AnttiLukats/OZOM-Model-A/README.md

# OZOM-Model-A
Open Hardware Zynq System on Module
