AnttiLukats/OZOM-Model-A/hw/pcb/manufacturing reports/PDF/SCH-ZOM-01.pdf

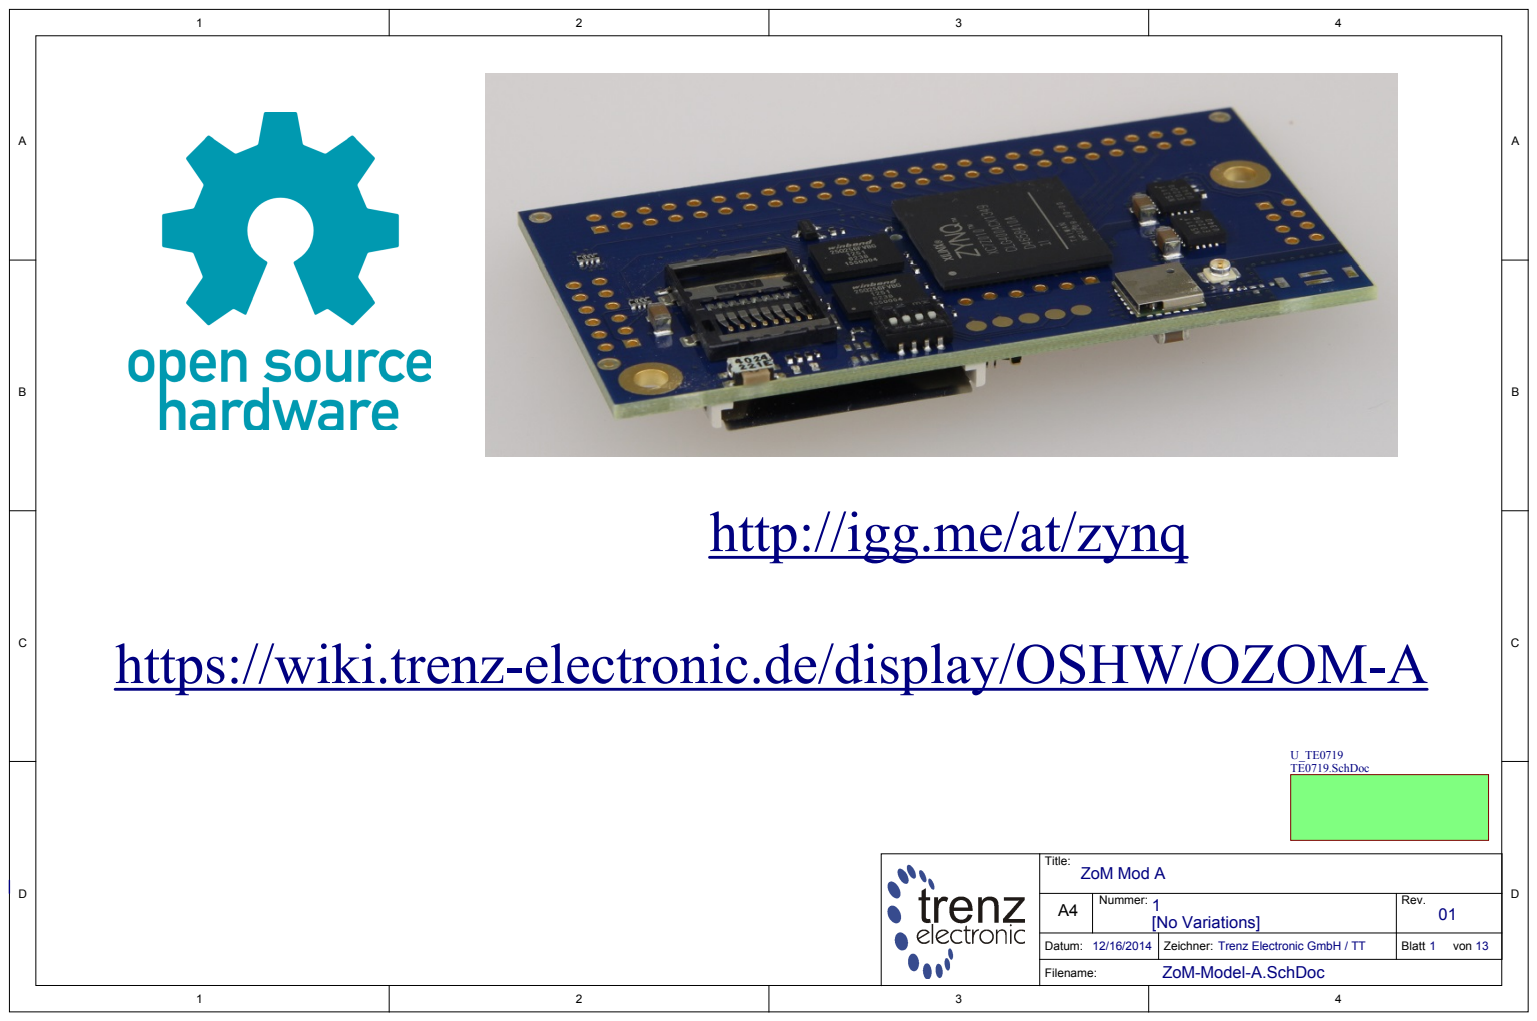
[picture p1: page 1]

http://igg.me/at/zynq

https://wiki.trenz-electronic.de/display/OSHW/OZOM-A

Title: ZoM Mod A

A4 | Nummer: 1 [No Variations] | Rev. 01

Datum: 12/16/2014 | Zeichner: Trenz Electronic GmbH / TT | Blatt 1 von 13

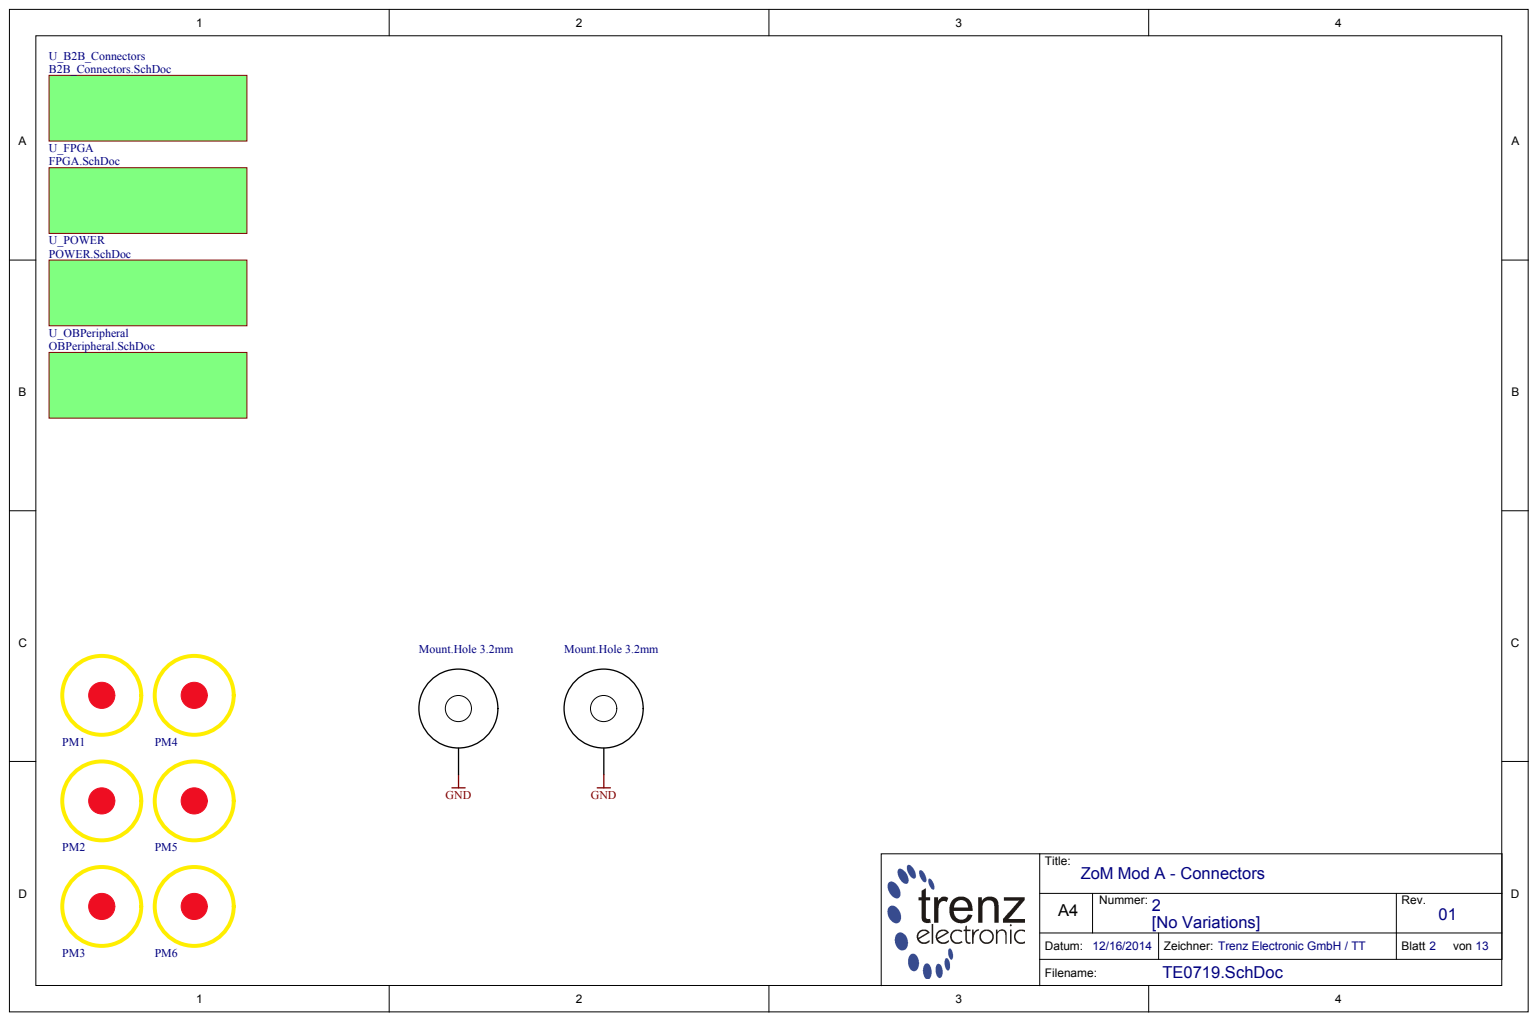
[picture p2: page 2]

Title: ZoM Mod A - Connectors

A4 | Nummer: 2 [No Variations] | Rev. 01

Datum: 12/16/2014 | Zeichner: Trenz Electronic GmbH / TT | Blatt 2 von 13

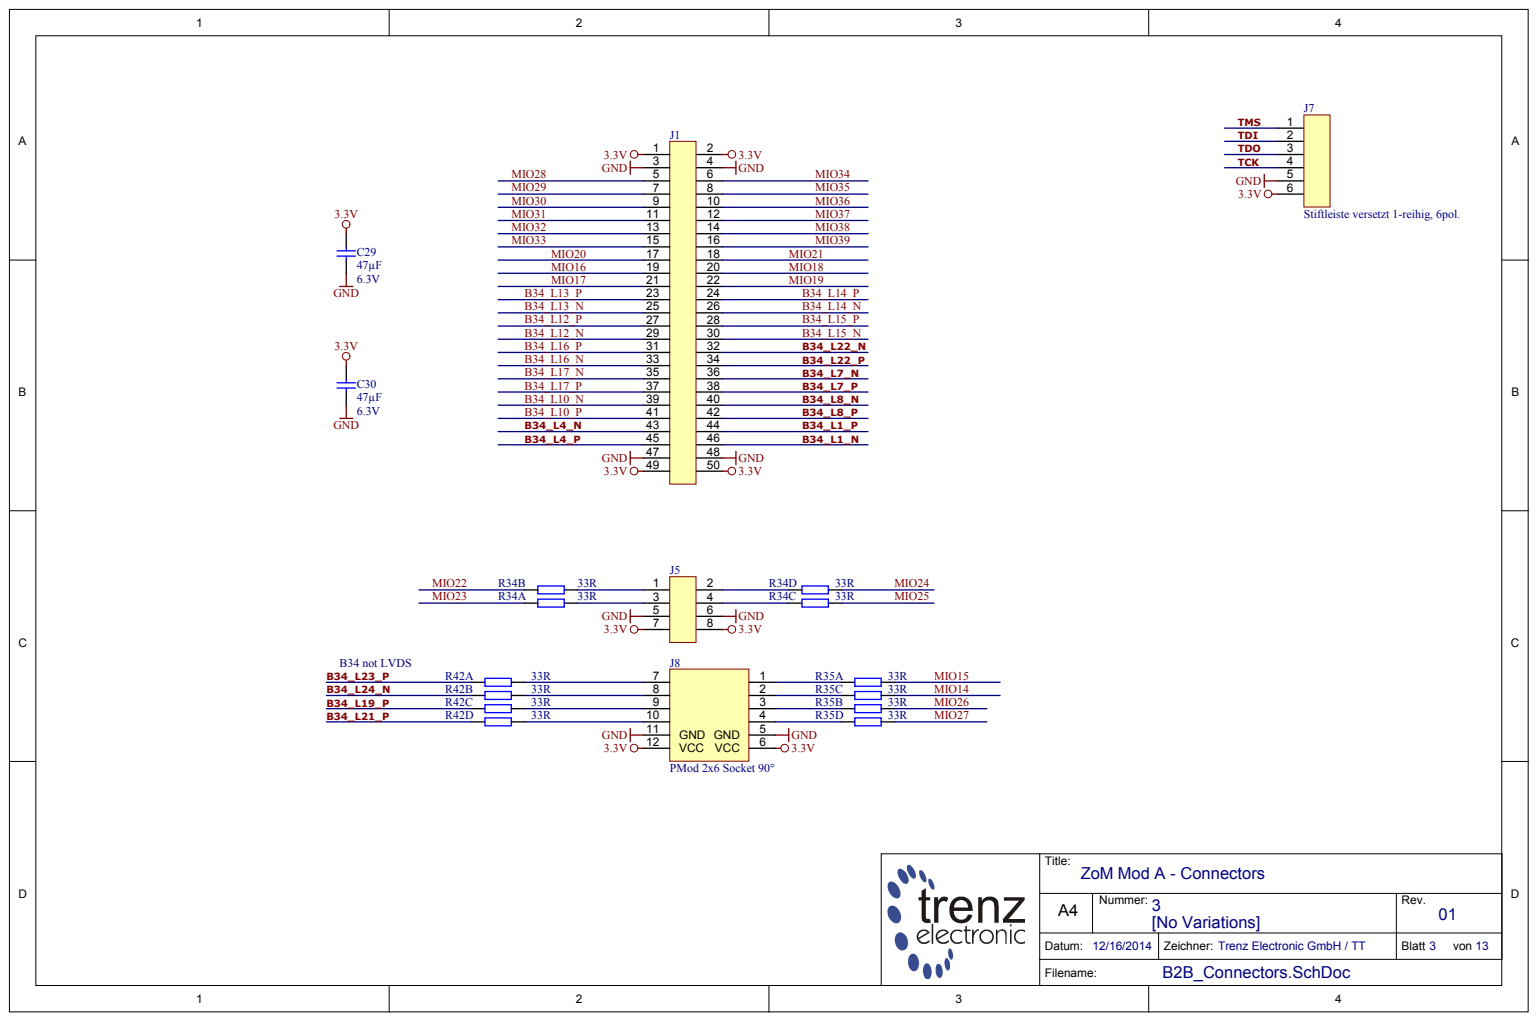
[picture p3: page 3]

TDI TDO TCK TMS

Title: ZoM Mod A - Connectors

A4 | Nummer: [No Variations] 3 | Rev. 01

Datum: 12/16/2014 | Zeichner: Trenz Electronic GmbH / TT | Blatt 3 von 13

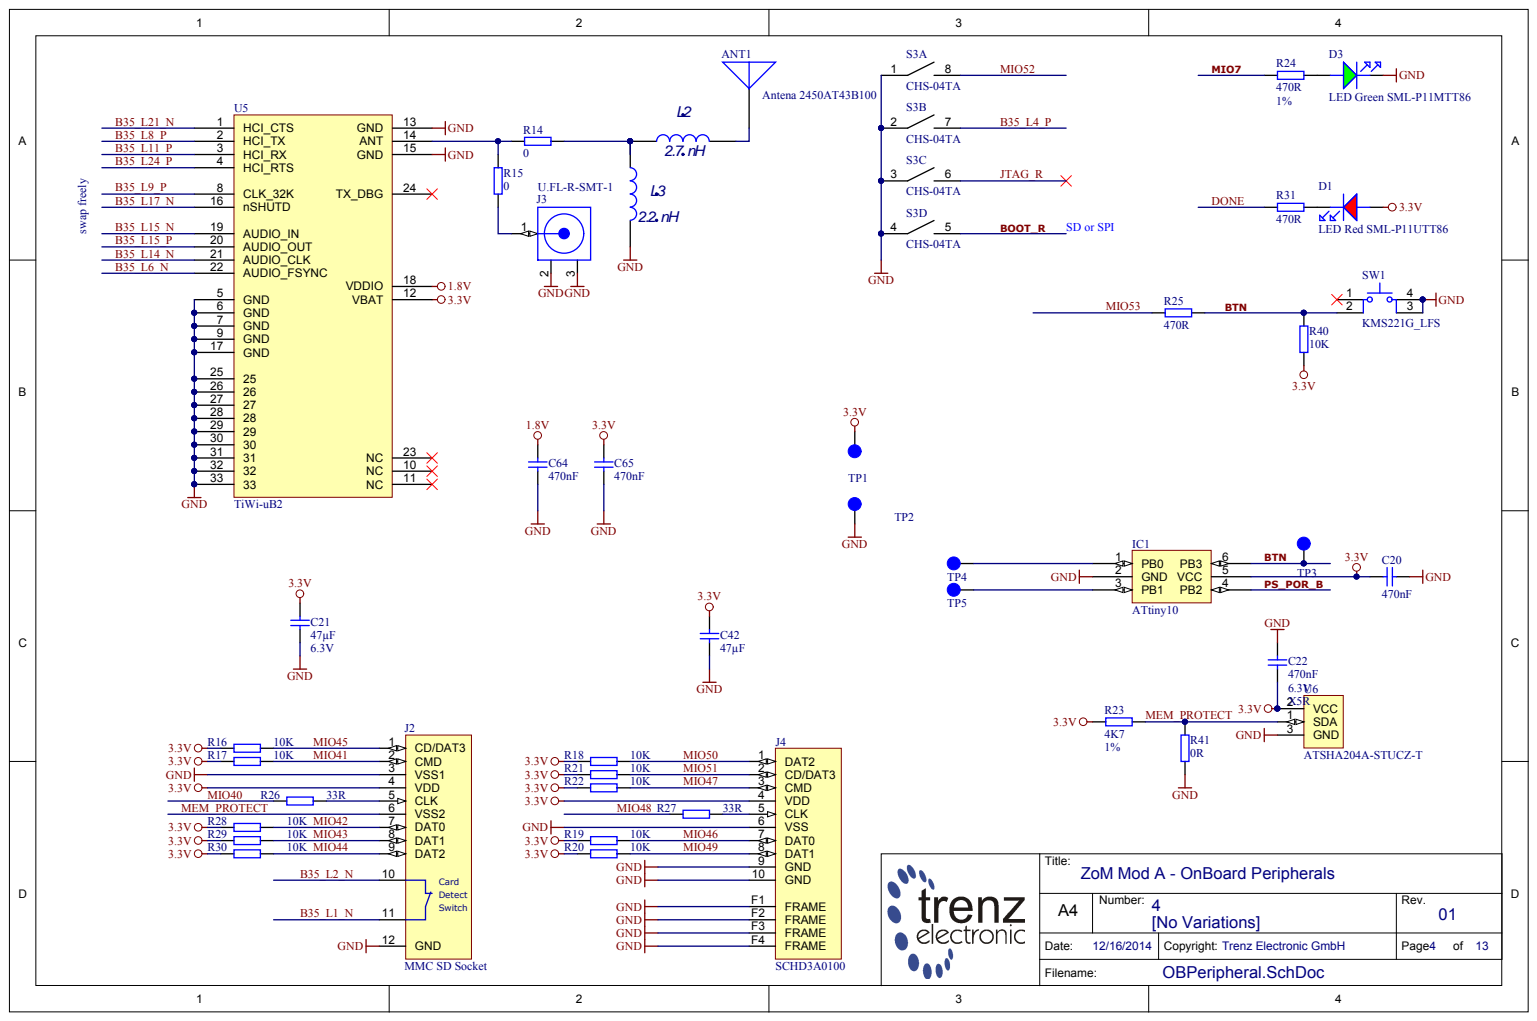
[picture p4: page 4]

Title: ZoM Mod A - OnBoard Peripherals

A4 | Number: 4 [No Variations] | Rev. 01

Copyright: Trenz Electronic GmbH

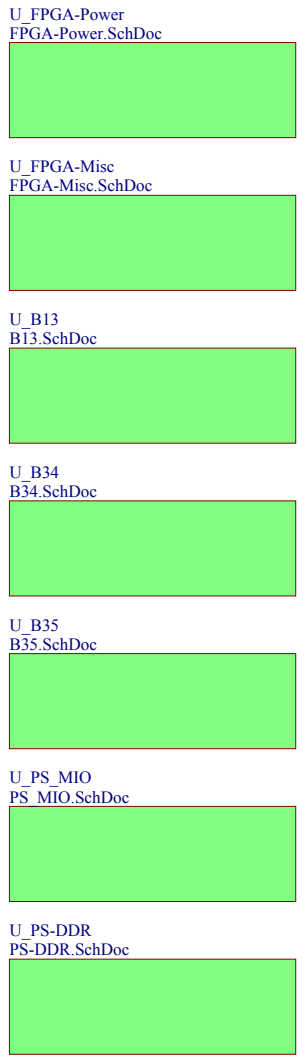
[picture p5: page 5]

Title: ZoM Mod A - FPGA

A4 | Number: 5 [No Variations] | Rev. 01

Date: 12/16/2014 | Copyright: Trenz Electronic GmbH | Page5 of 13

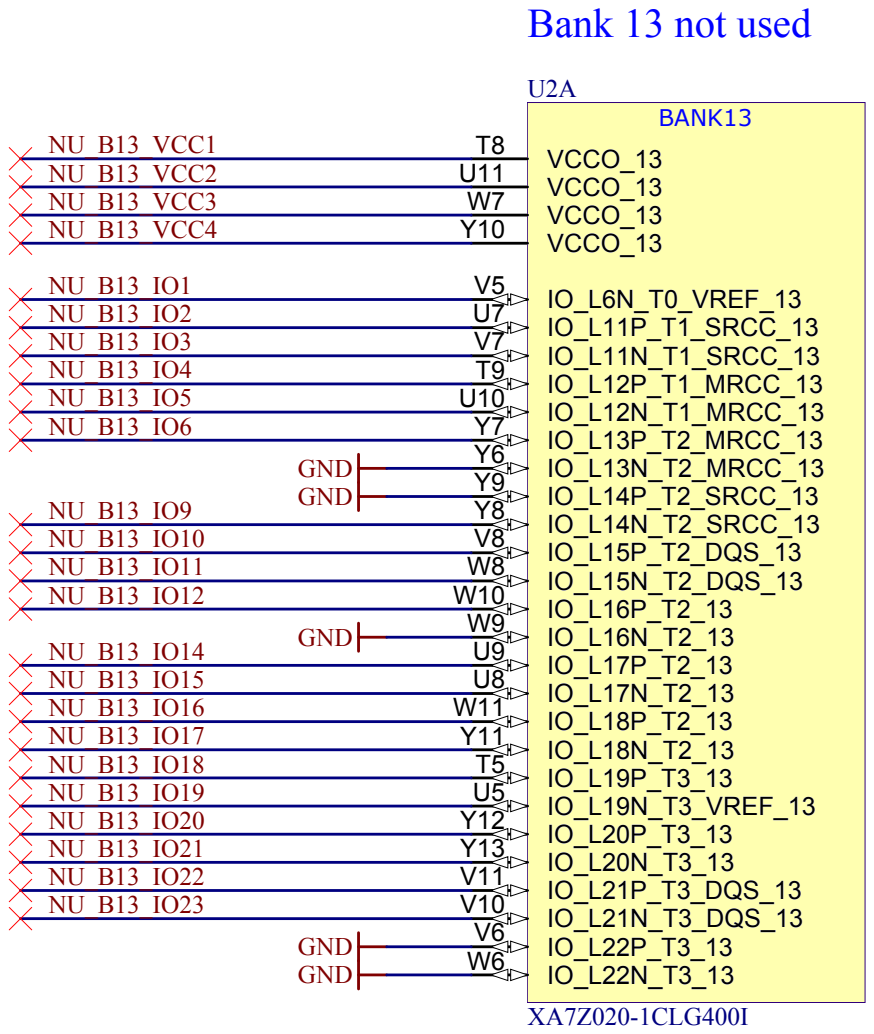
[picture p6: page 6]

Title: ZoM Mod A - FPGA Bank 13

A4 | Nummer: [No Variations] 6 | Rev. 01

Datum: 12/16/2014 | Zeichner: Trenz Electronic GmbH / TT | Blatt 6 von 13

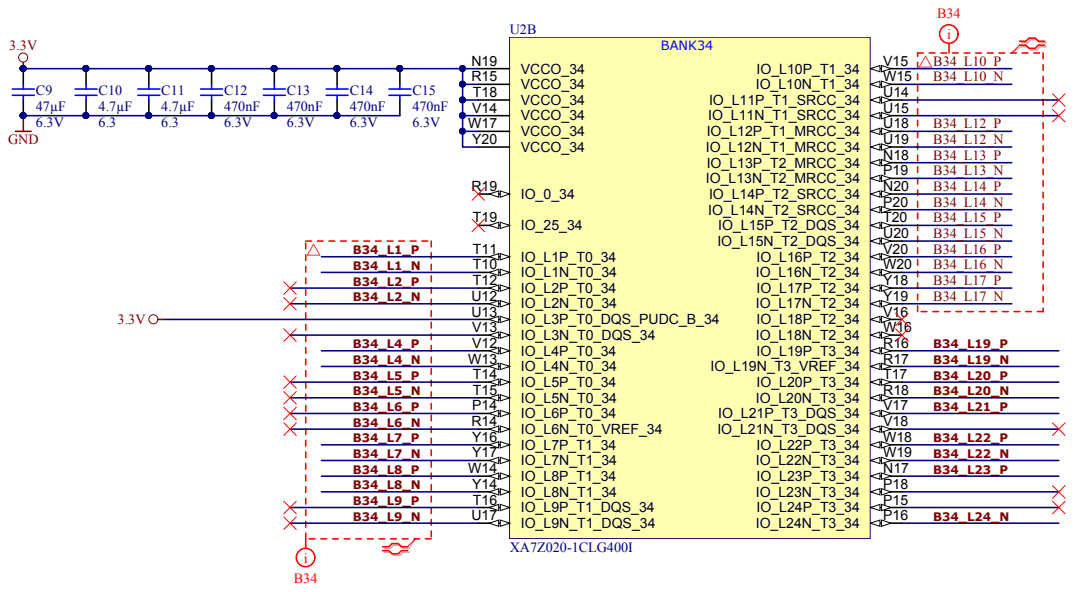
[picture p7: page 7]

Title: ZoM Mod A - FPGA Bank 34

A4 | Nummer: [No Variations] 7 | Rev. 01

Datum: 12/16/2014 | Zeichner: Trenz Electronic GmbH / TT | Blatt 7 von 13

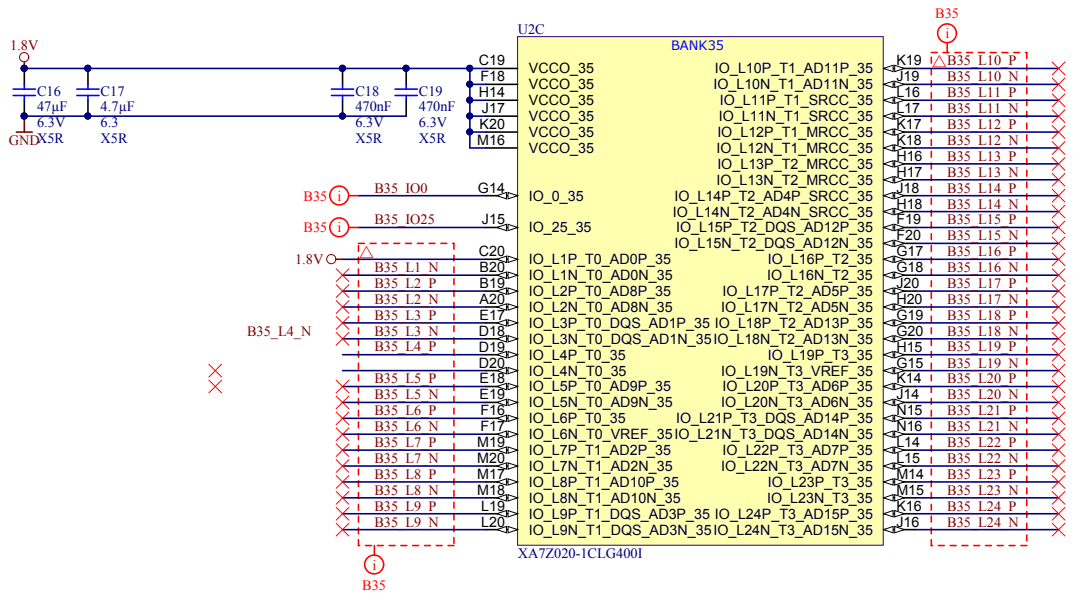
[picture p8: page 8]

IO_L1P_T0_AD0P_35 C20
IO_L1N_T0_AD0N_35 B20

B35_L2_P | IO_L2P_T0_AD8P_35 B19
B35_L2_N | IO_L2N_T0_AD8N_35 A20
B35_L3_P | IO_L3P_T0_DQS_AD1P_35 E17
B35_L3_N | IO_L3N_T0_DQS_AD1N_35 D18
B35_L4_P | IO_L4P_T0_35 D19

B35_L5_P | IO_L5P_T0_AD9P_35 E18
B35_L5_N | IO_L5N_T0_AD9N_35 E19
B35_L6_P | IO_L6P_T0_35 F16
B35_L6_N | IO_L6N_T0_VREF_35 F17
B35_L7_P | IO_L7P_T1_AD2P_35 M19
B35_L7_N | IO_L7N_T1_AD2N_35 M20
B35_L8_P | IO_L8P_T1_AD10P_35 M17
B35_L8_N | IO_L8N_T1_AD10N_35 M18
B35_L9_P | IO_L9P_T1_DQS_AD3P_35 L19
B35_L9_N | IO_L9N_T1_DQS_AD3N_35 L20

Title: ZoM Mod A - FPGA Bank 35

A4 | Nummer: [No Variations] 8 | Rev. 01

Datum: 12/16/2014 | Zeichner: Trenz Electronic GmbH / TT | Blatt 8 von 13

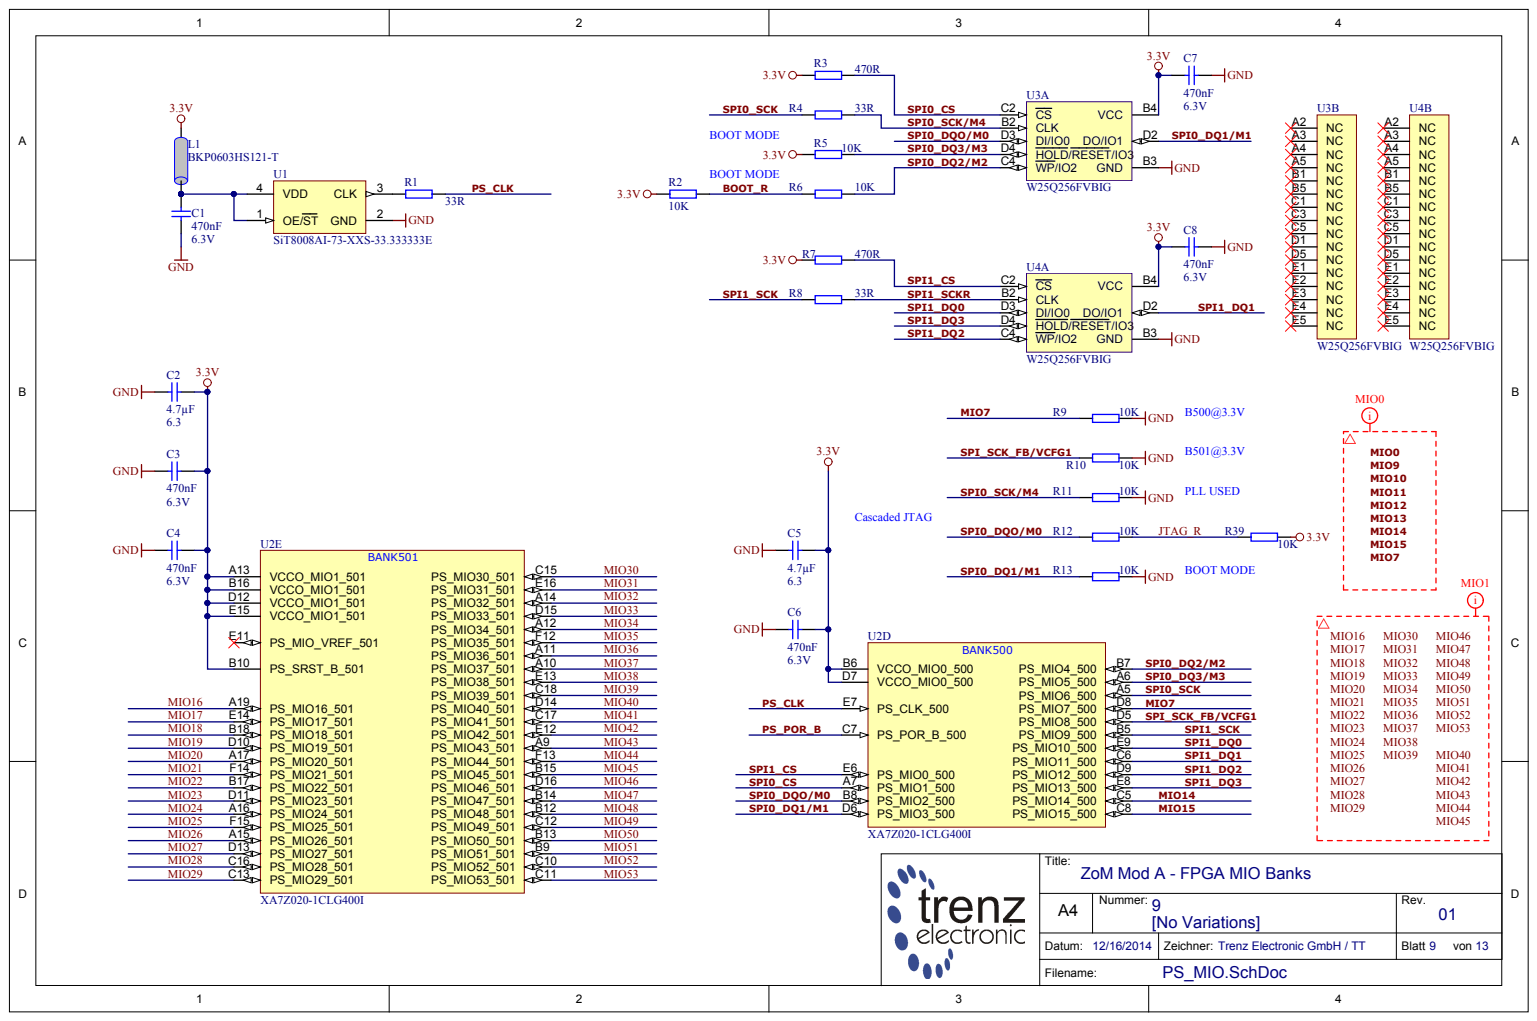
[picture p9: page 9]

Title: ZoM Mod A - FPGA MIO Banks

A4 | Nummer: 9 [No Variations] | Rev. 01

Datum: 12/16/2014 | Zeichner: Trenz Electronic GmbH / TT | Blatt 9 von 13

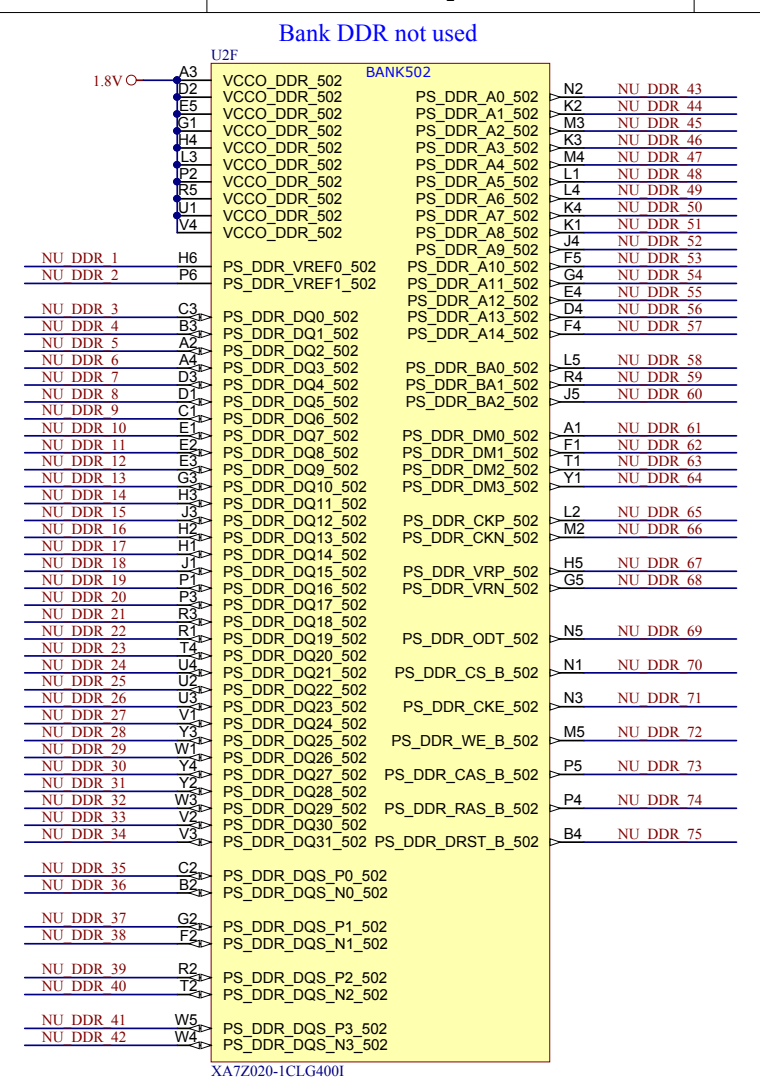
[picture p10: page 10]

Bank DDR not used

Title: ZoM Mod A - FPGA DDR Bank

A4 | Nummer: 10 [No Variations] | Rev. 01

Datum: 12/16/2014 | Zeichner: Trenz Electronic GmbH / TT | Blatt 10 von 13

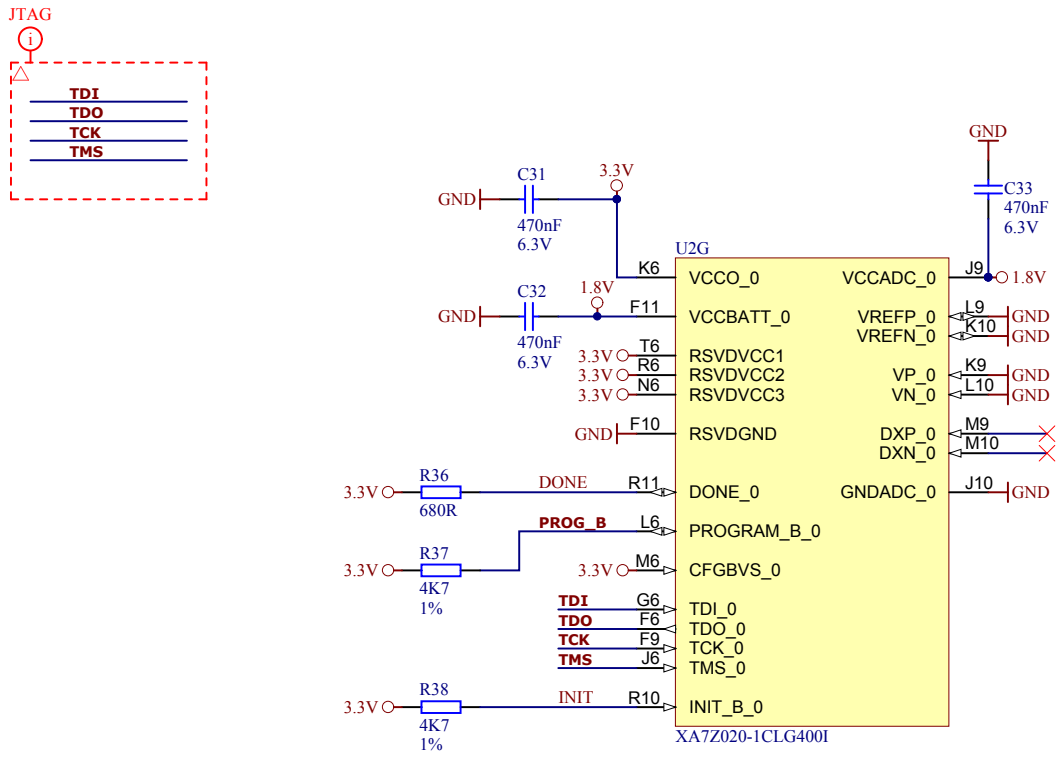
[picture p11: page 11]

Title: ZoM Mod A - FPGA MIsc

A4 | Nummer: 11 [No Variations] | Rev. 01

Datum: 12/16/2014 | Zeichner: Trenz Electronic GmbH / TT | Blatt 11 von 13

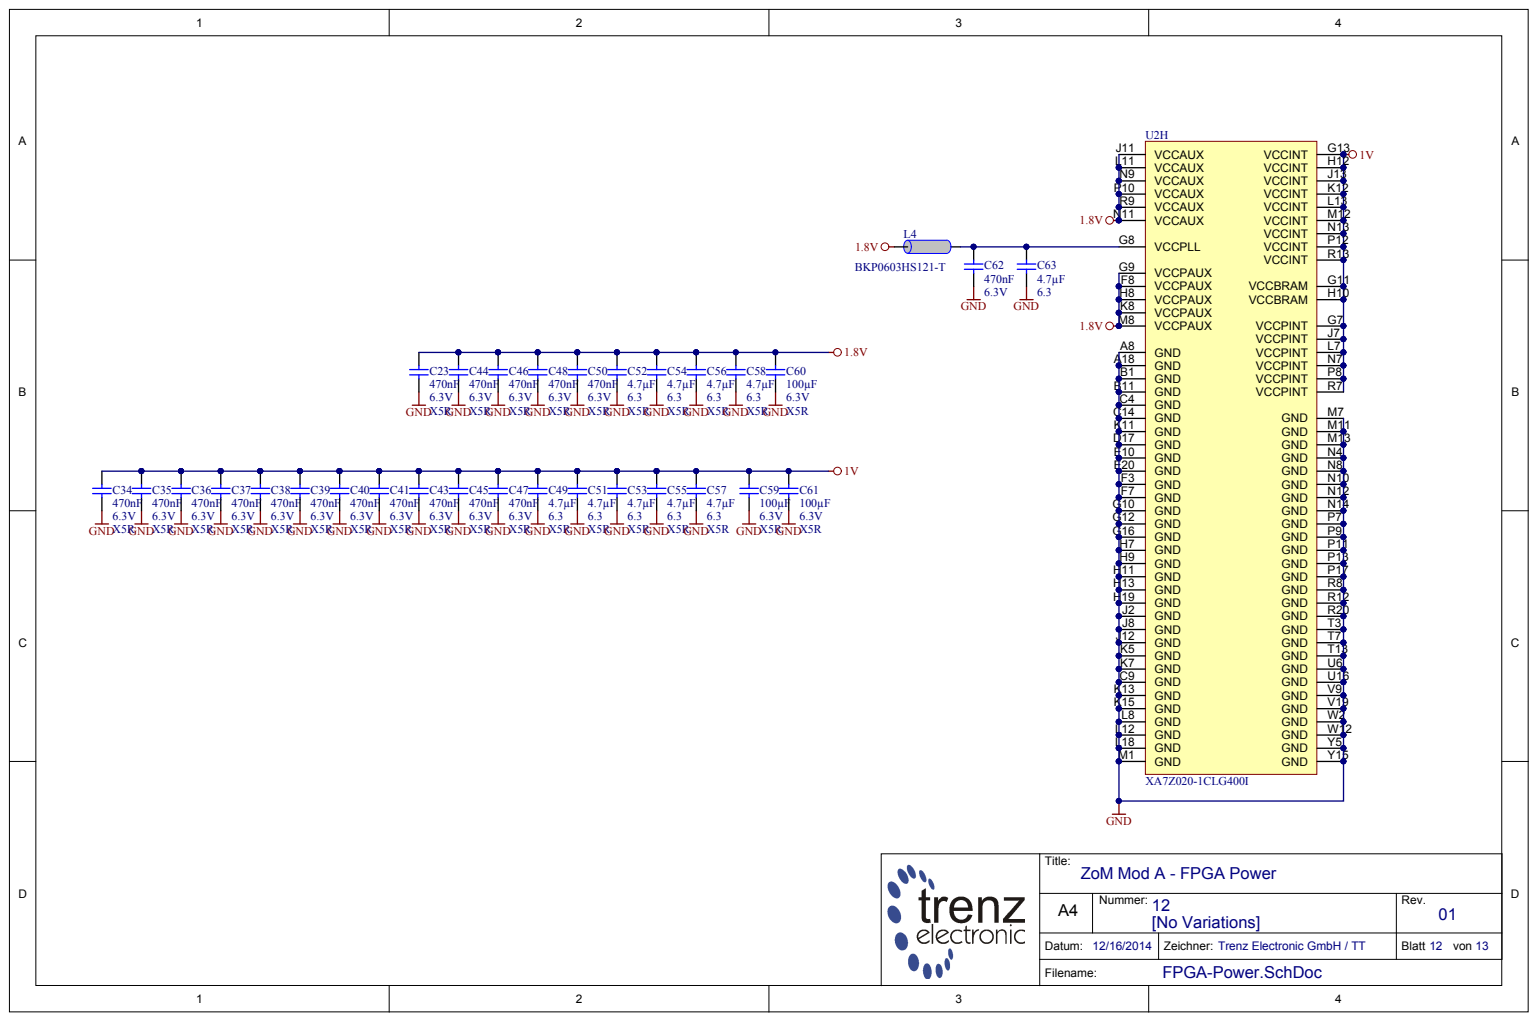
[picture p12: page 12]

Title: ZoM Mod A - FPGA Power

A4 | Nummer: 12 [No Variations] | Rev. 01

Datum: 12/16/2014 | Zeichner: Trenz Electronic GmbH / TT | Blatt 12 von 13

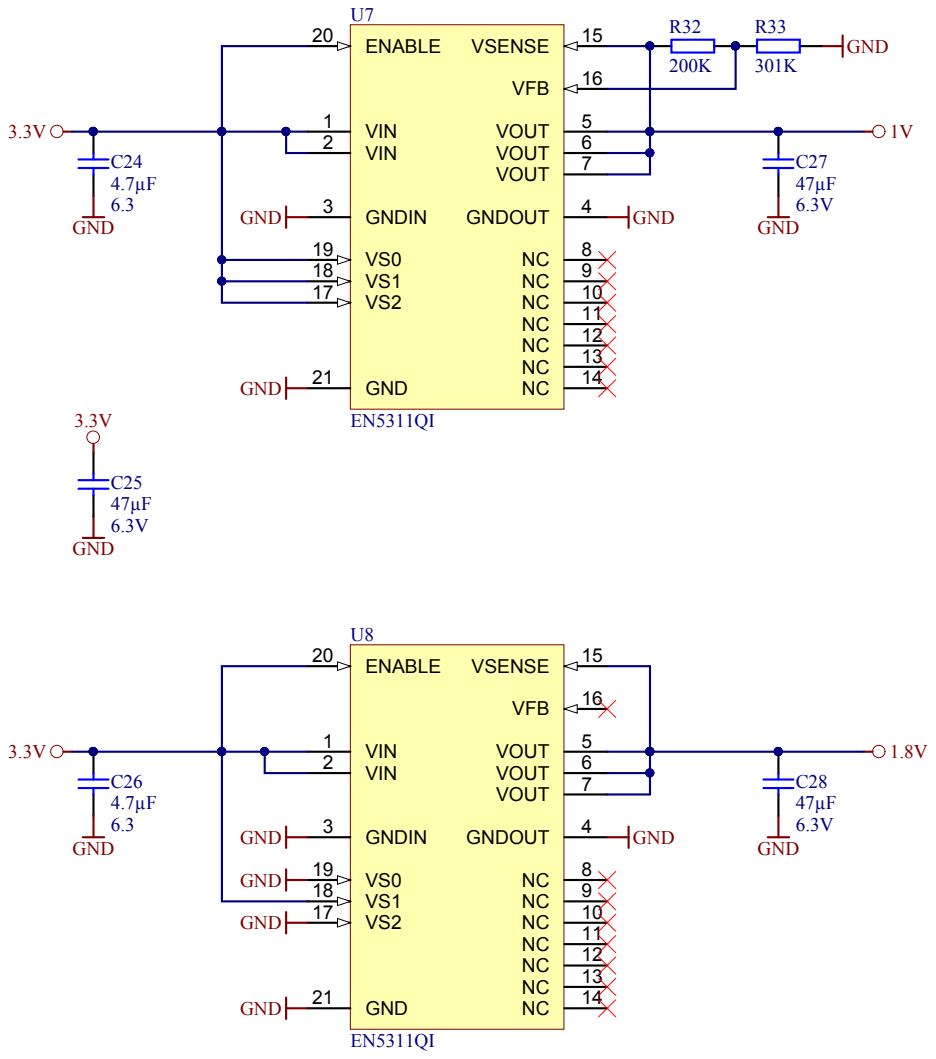
[picture p13: page 13]

Title: ZoM Mod A - Power

A4 | Number: 13 [No Variations] | Rev. 01

Date: 12/16/2014 | Copyright: Trenz Electronic GmbH | Page13 of 13
