AnttiLukats/OZOM-Model-A/hw/pcb/manufacturing reports/PDF/3D-ZOM-01-bottom.PDF

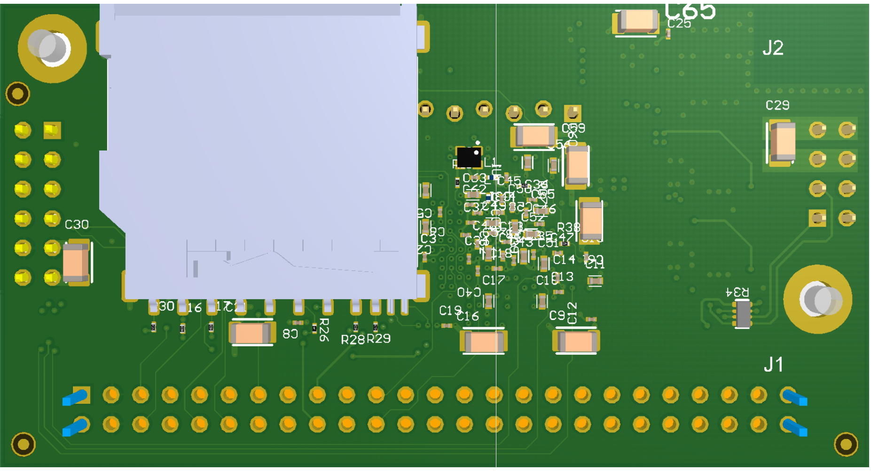
[picture p14: page 1]
