AnttiLukats/OZOM-Model-A/hw/pcb/manufacturing reports/PDF/3D-ZOM-01-top.PDF

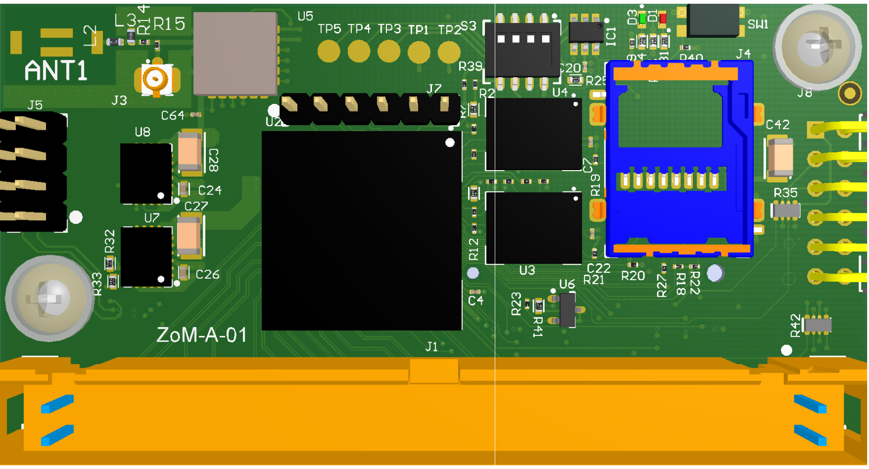
[picture p15: page 1]
