AnttiLukats/OZOM-Model-A/hw/pcb/manufacturing reports/PDF/AD-CY-ZOM-01.PDF

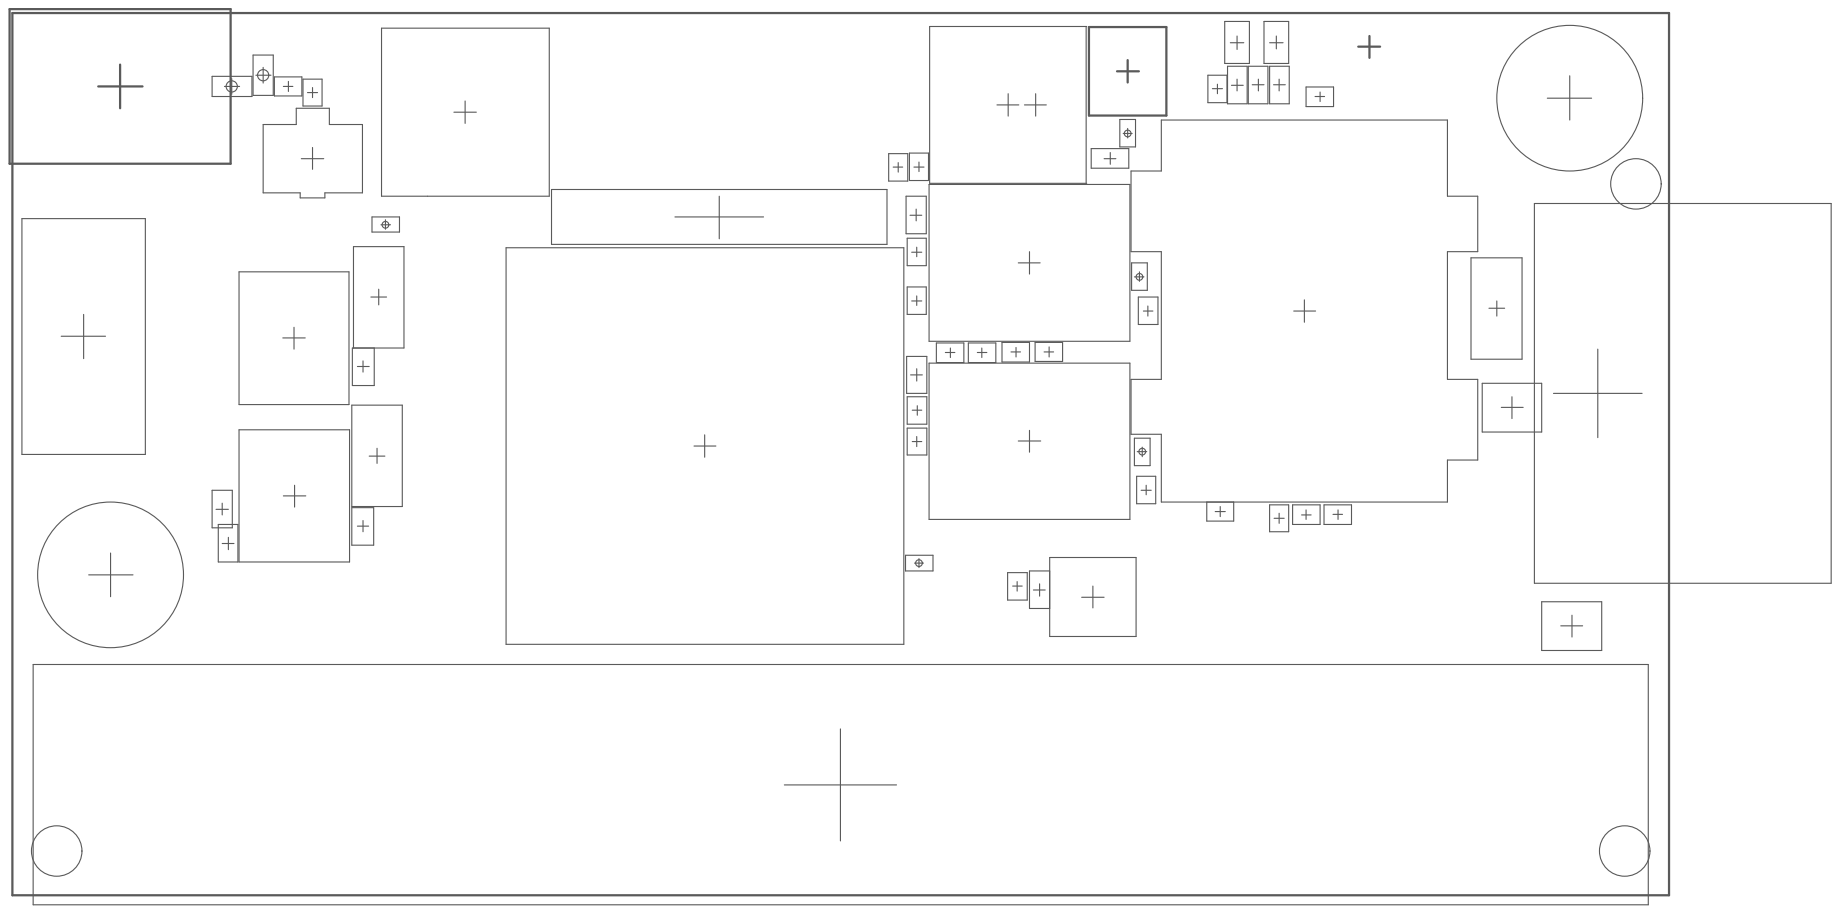
[picture p16: page 1]

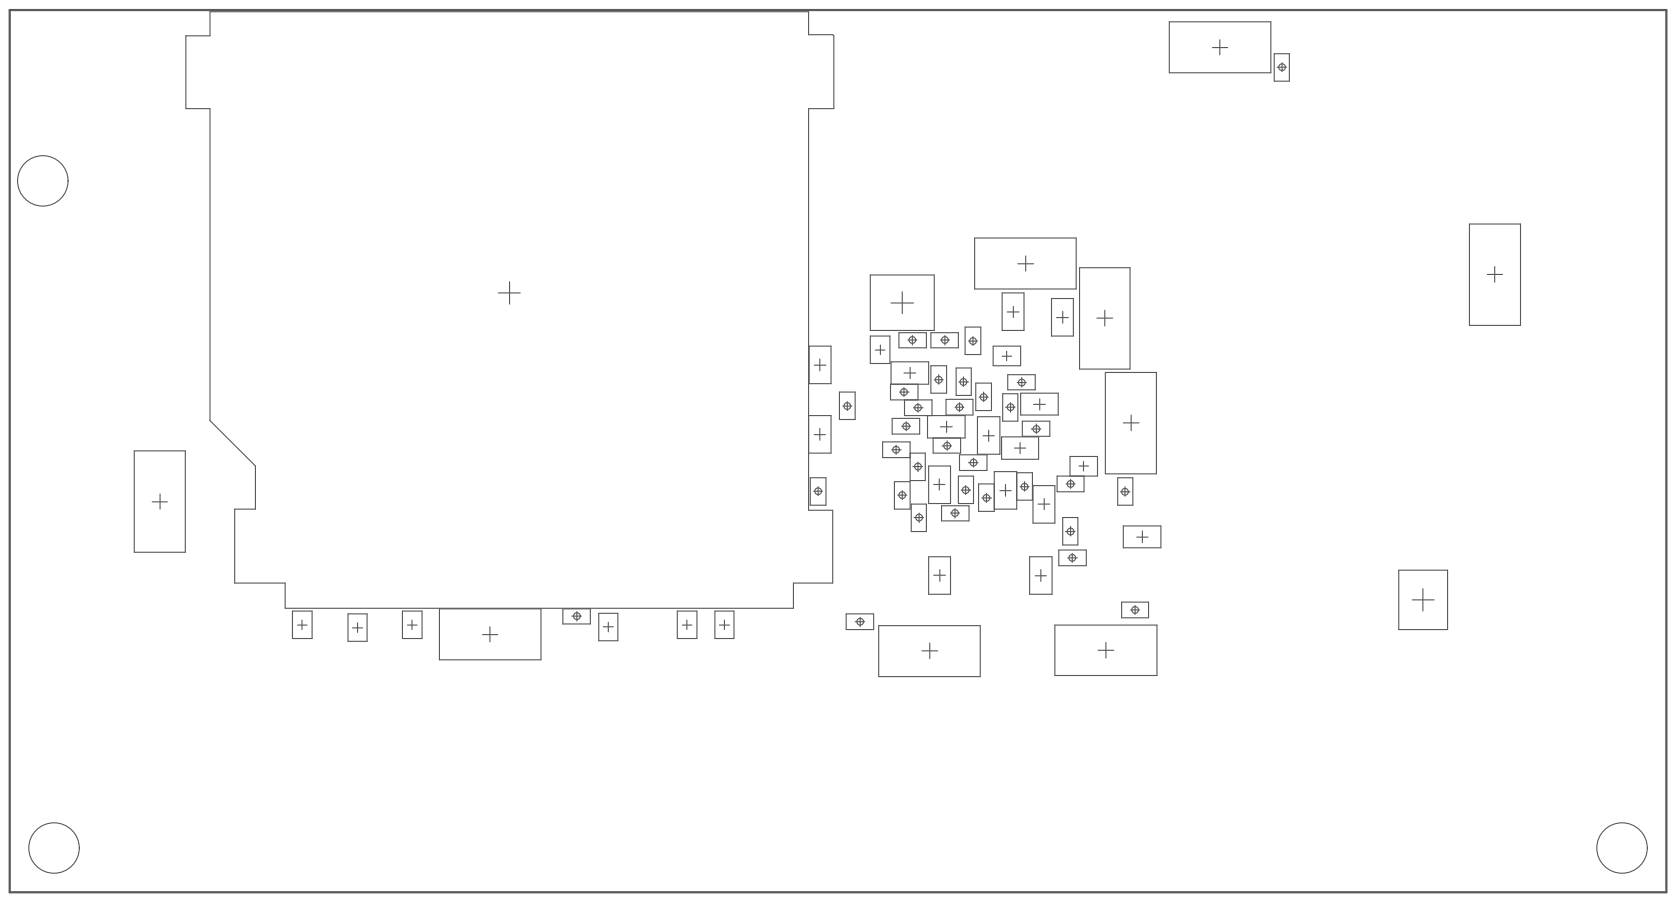
[picture p17: page 2]
