AnttiLukats/OZOM-Model-A/hw/pcb/manufacturing reports/PDF/AD-ZOM-01.PDF

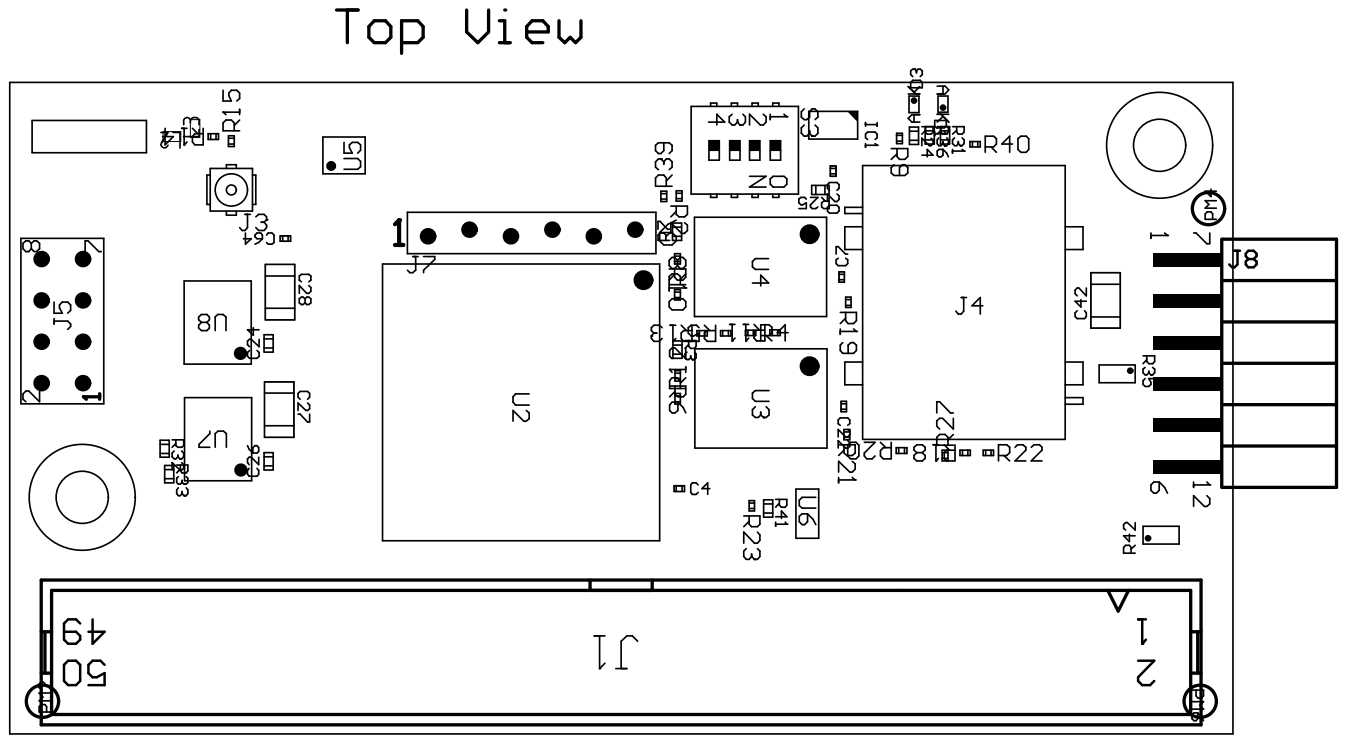
[picture p18: page 1]

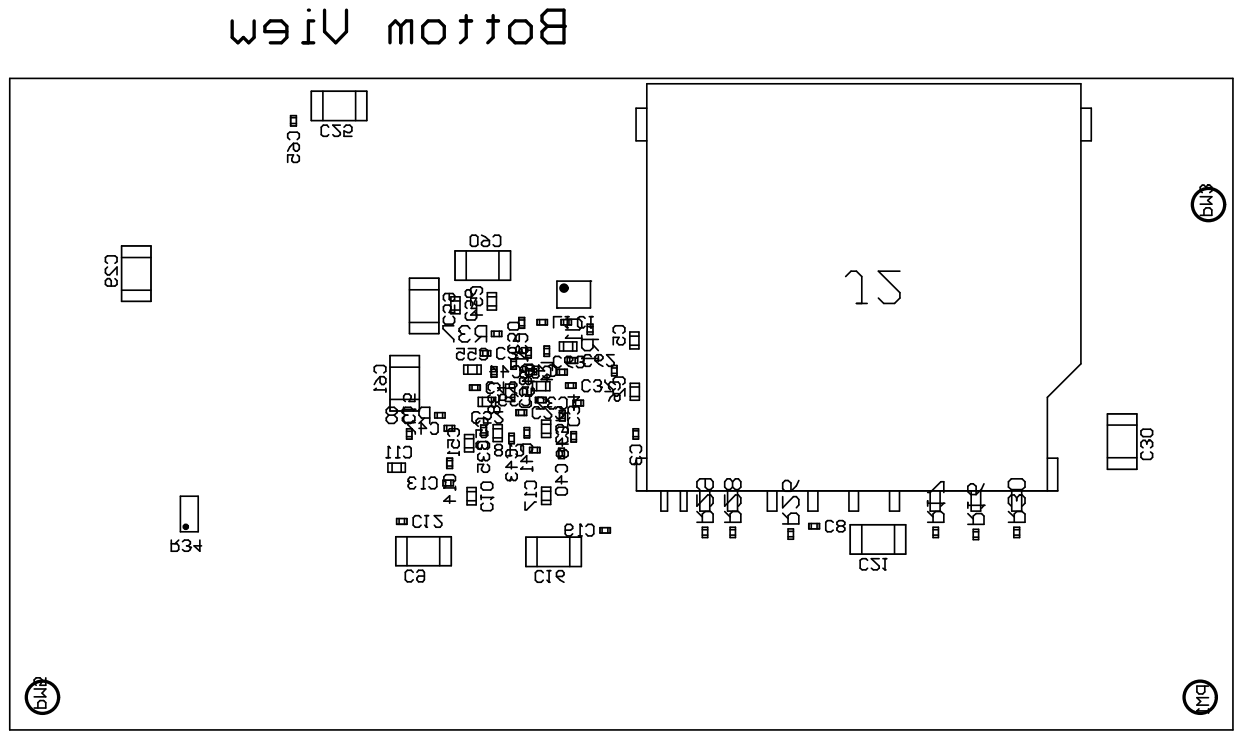
[picture p19: page 2]

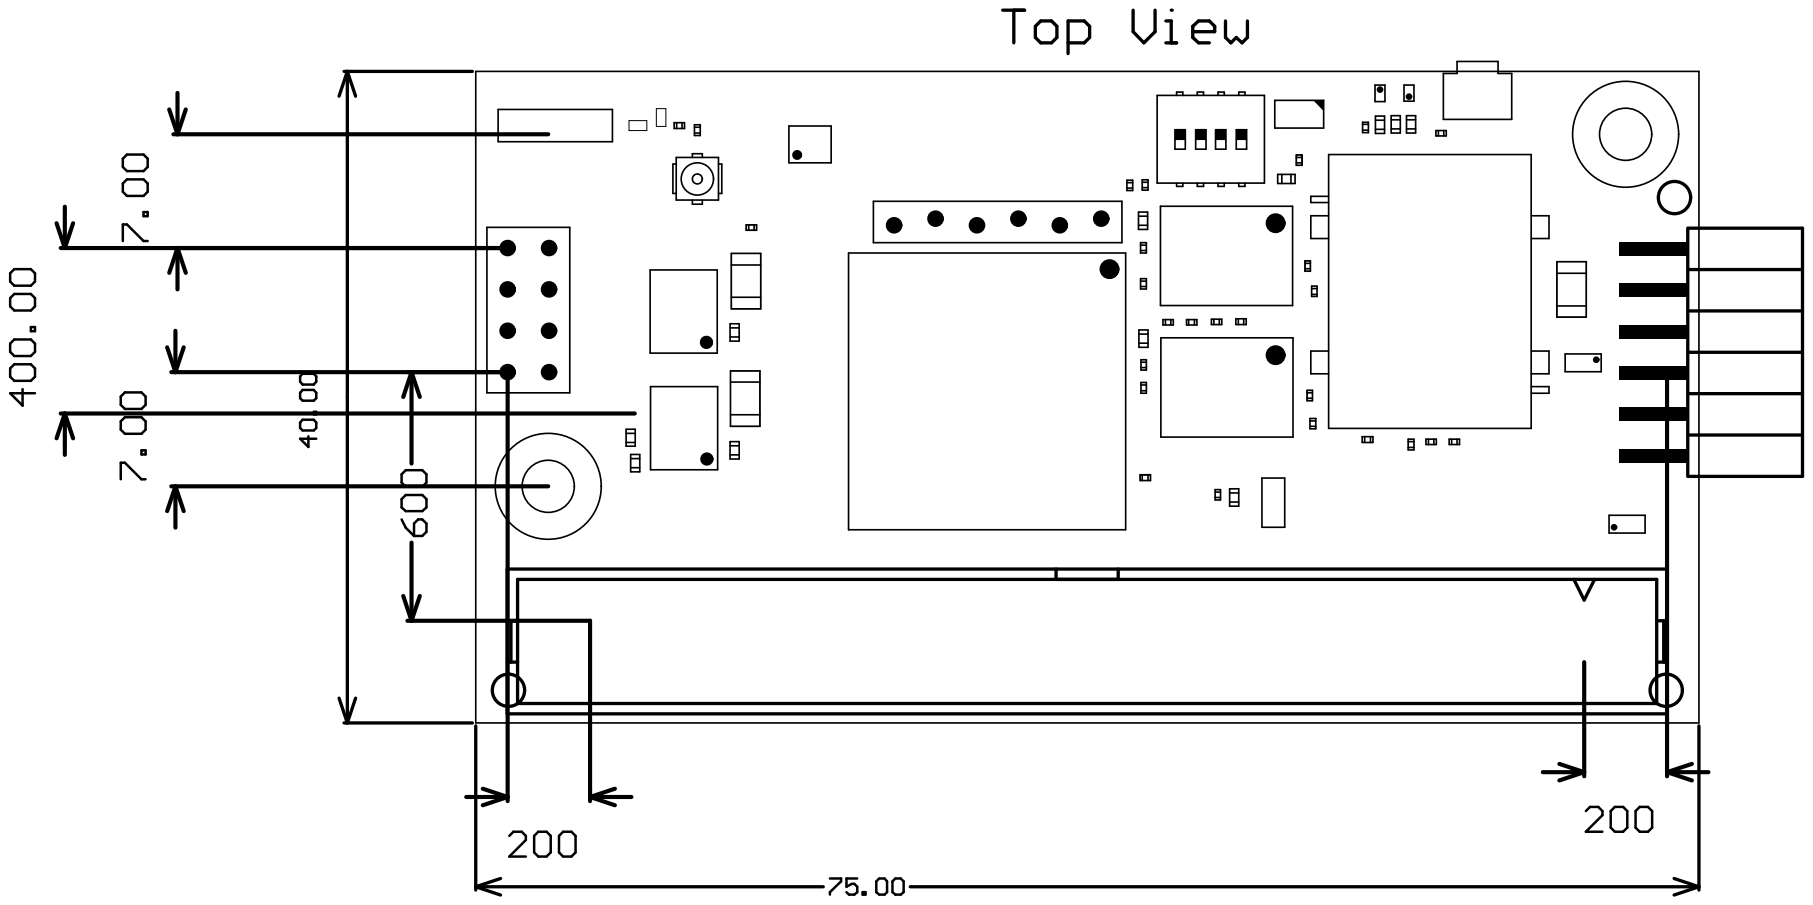
[picture p20: page 3]

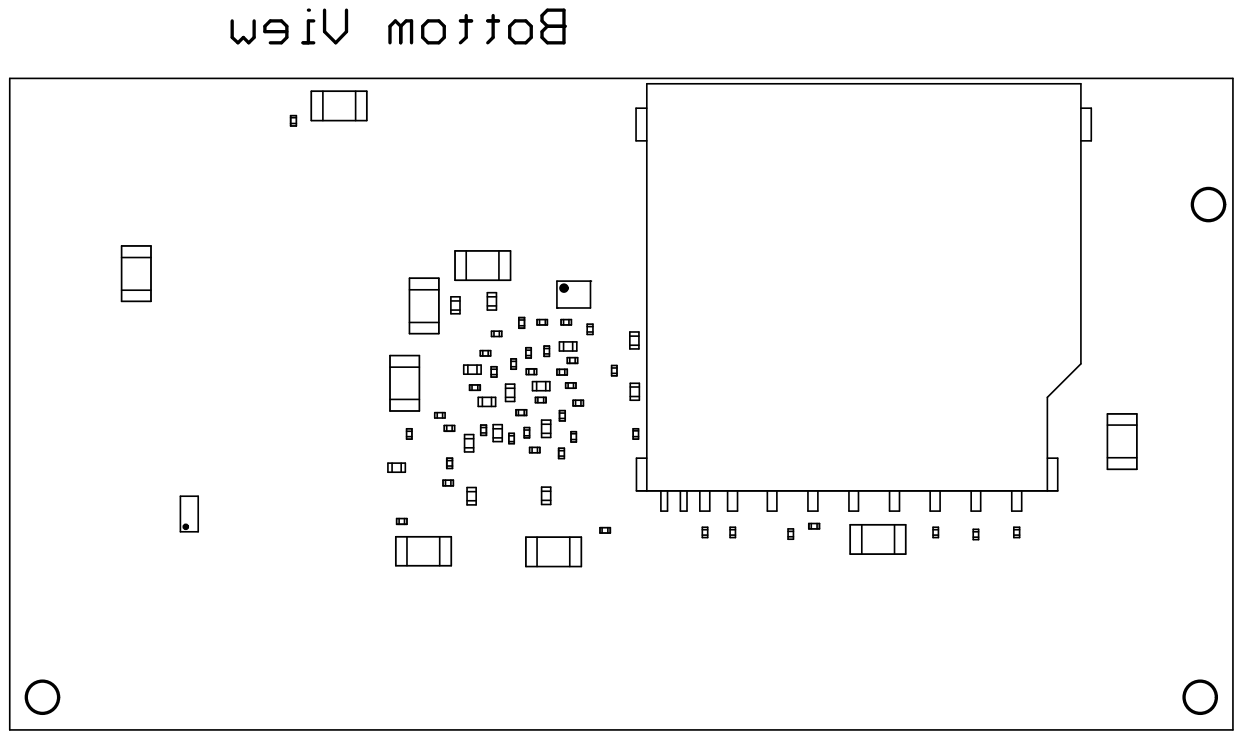
[picture p21: page 4]
