AnttiLukats/OZOM-Model-A/(list of files, drawings)

Other design files:
hw/pcb/B13.SchDoc
hw/pcb/B34.SchDoc
hw/pcb/B35.SchDoc
hw/pcb/FPGA-Misc.SchDoc
hw/pcb/FPGA-Power.SchDoc
hw/pcb/FPGA.SchDoc
hw/pcb/OBPeripheral.SchDoc
hw/pcb/POWER.SchDoc
hw/pcb/PS-DDR.SchDoc
hw/pcb/PS_MIO.SchDoc
hw/pcb/TE0719.SchDoc
hw/pcb/ZoM-Model-A.PrjPCB
hw/pcb/ZoM-Model-A.SchDoc
